ramesh-create/SolarTrakerESP32/esp32SolarTracker/pc/gitter.png

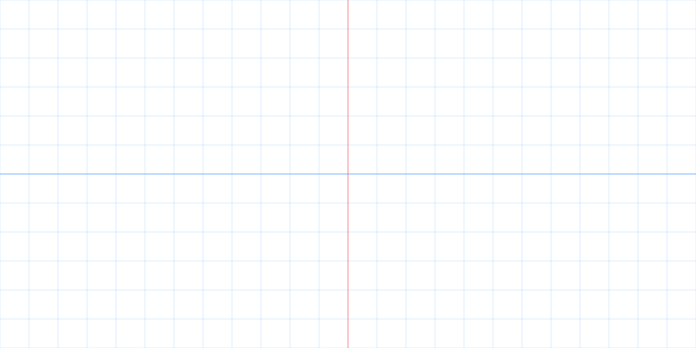
esp32SolarTracker/pc/gitter.png
