ramesh-create/SolarTrakerESP32/esp32SolarTracker/pc/weltkarte.png

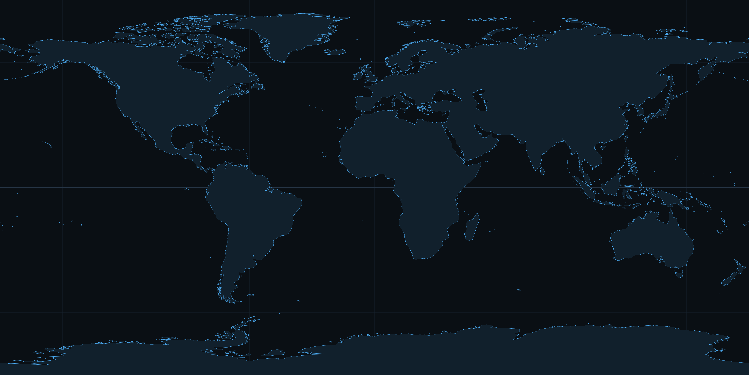
esp32SolarTracker/pc/weltkarte.png
