ramesh-create/SolarTrakerESP32/esp32SolarTracker/pc/weltkarte_plexus.png

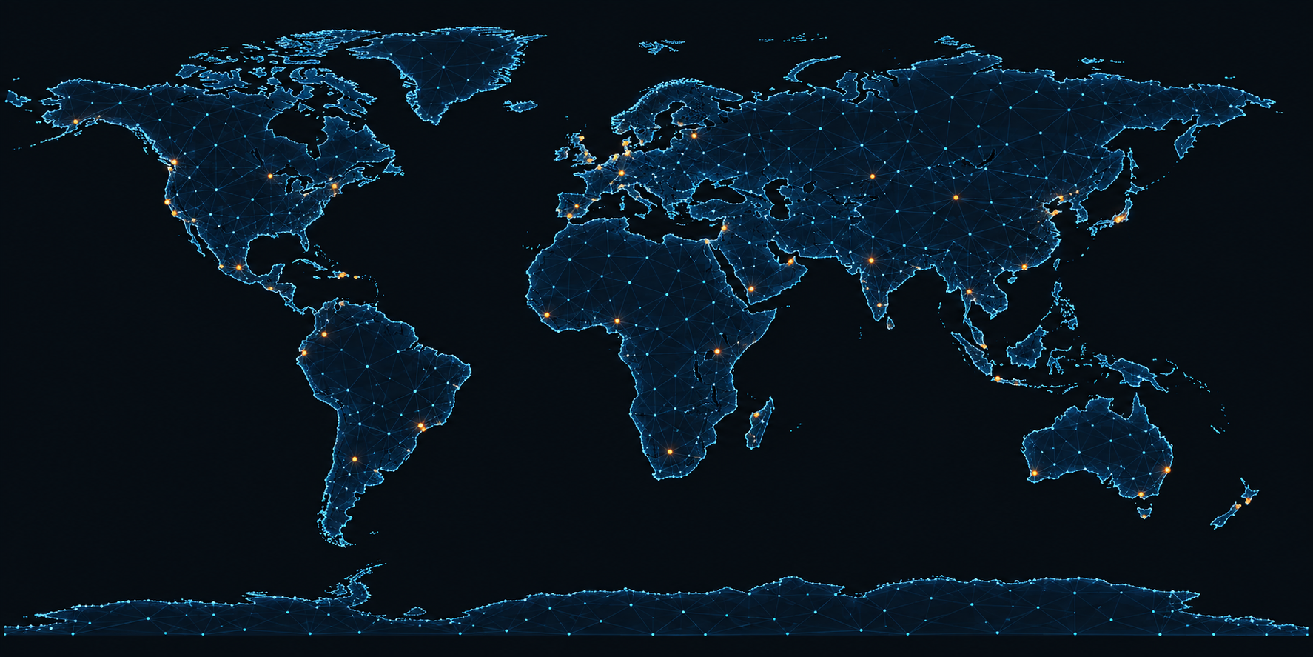
esp32SolarTracker/pc/weltkarte_plexus.png
