ramesh-create/SolarTrakerESP32/esp32SolarTracker/Schaltplan4HTwlEdJ0sPyY.jpg

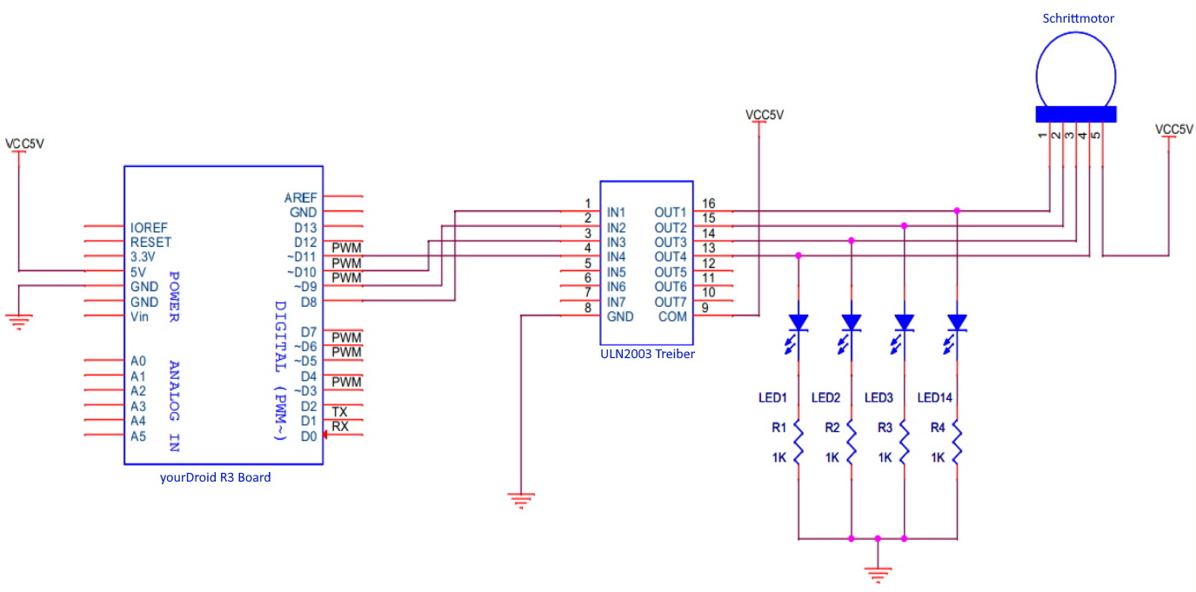
esp32SolarTracker/Schaltplan4HTwlEdJ0sPyY.jpg
