ramesh-create/SolarTrakerESP32/schematics/Screenshot 2026-07-09 111910.png

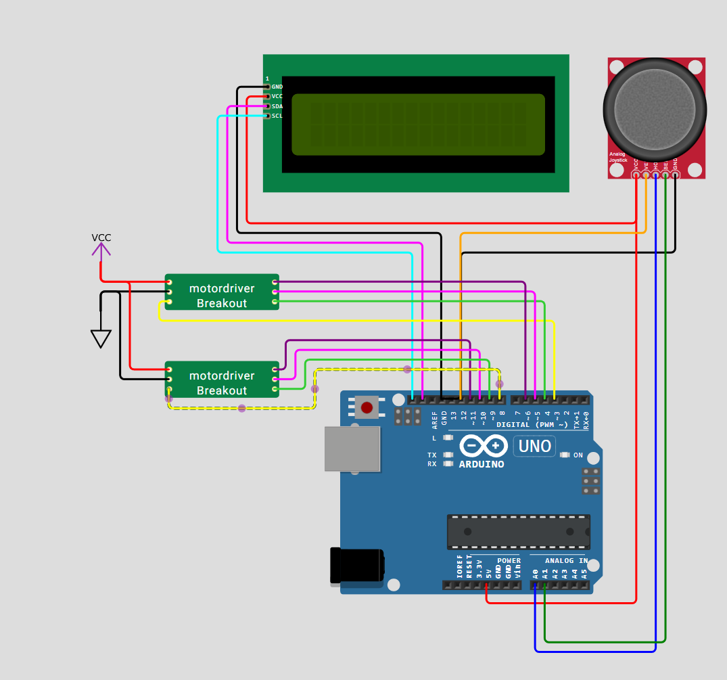
schematics/Screenshot 2026-07-09 111910.png
