ramesh-create/SolarTrakerESP32/(commit log)

2026-09-22 ESP32 SolarTracker: PC-Bedienfeld 0.6.4, Firmware 0.6.0, Standalone 0.8
    [sonnenverlauf.csv]
2026-09-22 PC 0.6.6 / Firmware 0.6.2: Ortsfelder Land/Stadt, ORT-Befehl und LCD-Ortszeile
2026-09-24 PC 0.6.7: Offline-Ortsvorschlag (Natural Earth orte.json, orte.py) + Button
2026-09-25 PC 0.7.0 / Firmware 0.7.0: interaktiver 3D-Globus (QtQuick3D), Zeitzone (TZ), Button unter Karte
2026-09-25 PC 0.7.2: Kugel-Drehung korrigiert, Rad zoomt nur Kugel (kein Seiten-Scroll), Doppelklick auf Karte/Kugel setzt Position, Reset-Button unten rechts
    [bedienfeld_qt.py, design_basis.py, globus.py, steuerzentrale.py, weltkarte.py]
2026-09-25 PC 0.7.3: Globus-Doppelklick repariert (MouseArea), Doppelklick setzt Land/Stadt (Name auf Karte und Globus)
